nrw505/poweredge-fan-faker/eagle/fan-faker-1side.brd

## EAGLE design eagle/fan-faker-1side.brd (2015-07-03)

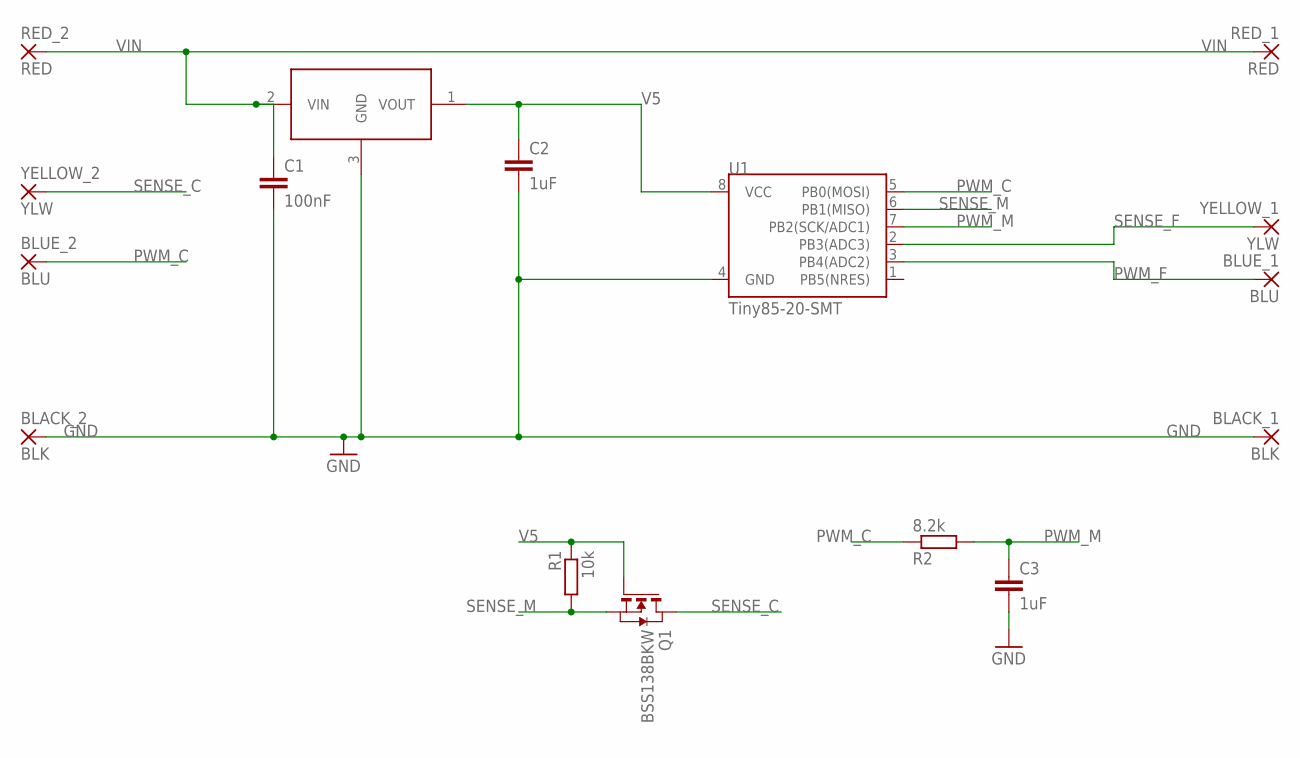
[picture p1: schematic fan-faker.sch]

Parts:
BLACK_1, BLACK_2: BLK; 2,54/1,0
BLUE_1, BLUE_2: BLU; 2,54/1,0
C1: 100nF; C0805K
C2, C3: 1uF; C0805K
Q1: BSS138BKW; SOT323
R1: 10k; R0805
R2: 8.2k; R0805
RED_1, RED_2: RED; 2,54/1,0
U1: Tiny85-20-SMT; SO08-EIAJ
U$2: LM3480; SOT23
YELLOW_1, YELLOW_2: YLW; 2,54/1,0

Connections:
GND: BLACK_1.1, BLACK_2.1, C1.2, C2.2, C3.2, U1.4 (GND), U$2.3 (GND)
PWM_C: BLUE_2.1, R2.1, U1.5 (PB0(MOSI))
PWM_F: BLUE_1.1, U1.3 (PB4(ADC2))
PWM_M: C3.1, R2.2, U1.7 (PB2(SCK/ADC1))
SENSE_C: Q1.1 (D), YELLOW_2.1
SENSE_F: U1.2 (PB3(ADC3)), YELLOW_1.1
SENSE_M: Q1.3 (S), R1.2, U1.6 (PB1(MISO))
V5: C2.1, Q1.2 (G), R1.1, U1.8 (VCC), U$2.1 (VOUT)
VIN: C1.1, RED_1.1, RED_2.1, U$2.2 (VIN)

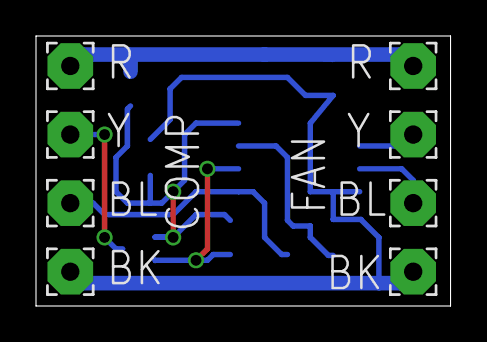
[picture p2: board fan-faker-1side.brd from above]

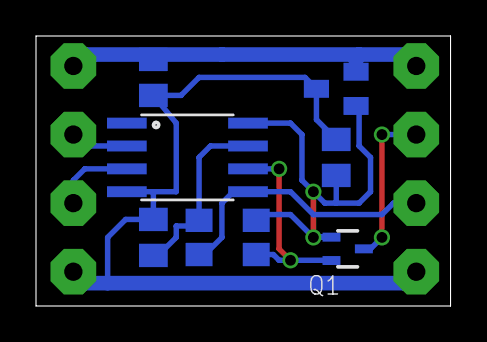
[picture p3: board fan-faker-1side.brd from below]

Board: 2 copper layers, 23.0 x 15.0 mm, 16 parts (8 on the bottom side), 9 nets.
