nrw505/poweredge-fan-faker/(commit log)

2015-06-28 Pull shared AVR/arduino makefile into repo
2015-06-29 Remove timer debug from PB0, it's actually supposed to be an input
2015-06-29 Works better if the input from an open-collector driver has a pull-up enabled
2015-06-29 note down what fuse settings should be
2015-06-29 Set fuse values in source, even if we don't automatically program them from there yet
2015-07-01 add makefile targets to write out the fuses that are specified in source
2015-07-03 Added schematic and board layouts
    [fan-faker-1side.brd, fan-faker-2sides.brd, fan-faker.sch]
